msk-1/xx-split-trackball-keyboard/out/step/plate-left.step

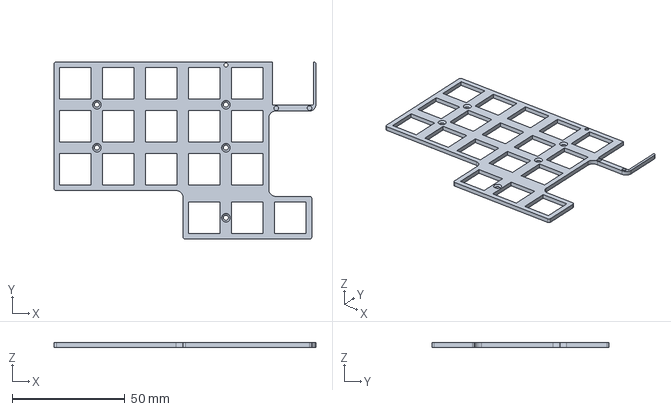
[picture p3: CAD file, 2026-11-07]
out/step/plate-left.step
116.1 x 78.6 x 2.00 mm
