msk-1/xx-split-trackball-keyboard/out/stl/asm/tag-left.stl

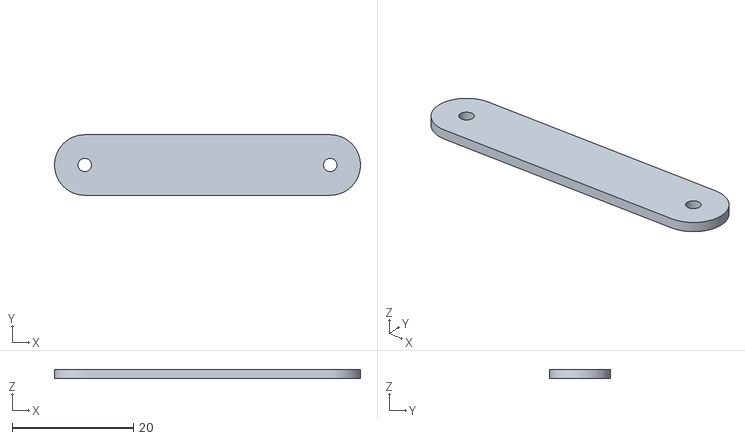
[picture p4: CAD file, 2026-11-07]
out/stl/asm/tag-left.stl
50.5 x 10.0 x 1.50
