msk-1/xx-split-trackball-keyboard/ref/BatteryHolder_Keystone_2460_1xAA.step

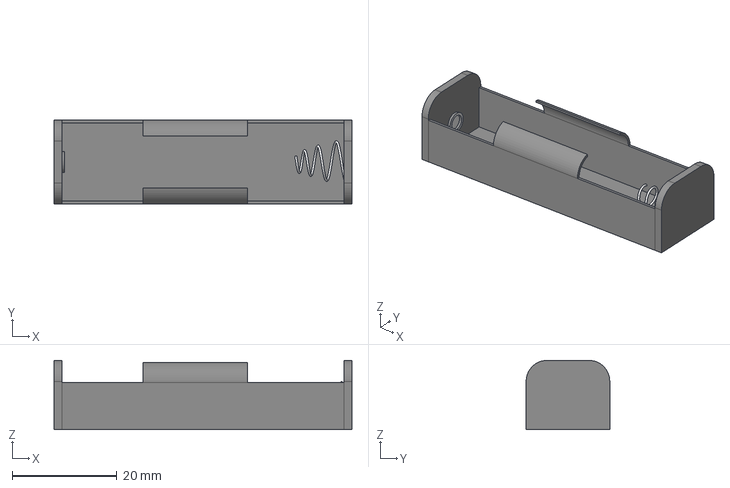
[picture p5: CAD file, 2026-11-07]
ref/BatteryHolder_Keystone_2460_1xAA.step
57.0 x 16.0 x 13.3 mm
