msk-1/xx-split-trackball-keyboard/out/step/battery-door-left.step

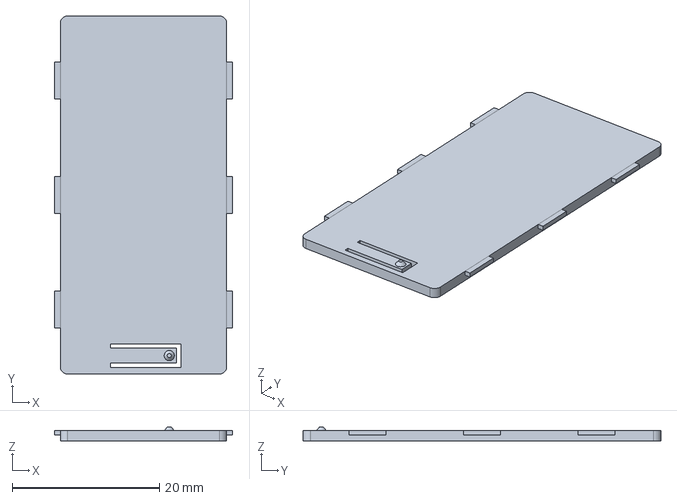
[picture p6: CAD file, 2026-11-07]
out/step/battery-door-left.step
24.2 x 48.6 x 1.89 mm
