msk-1/xx-split-trackball-keyboard/out/stl/asm/cover-right.stl

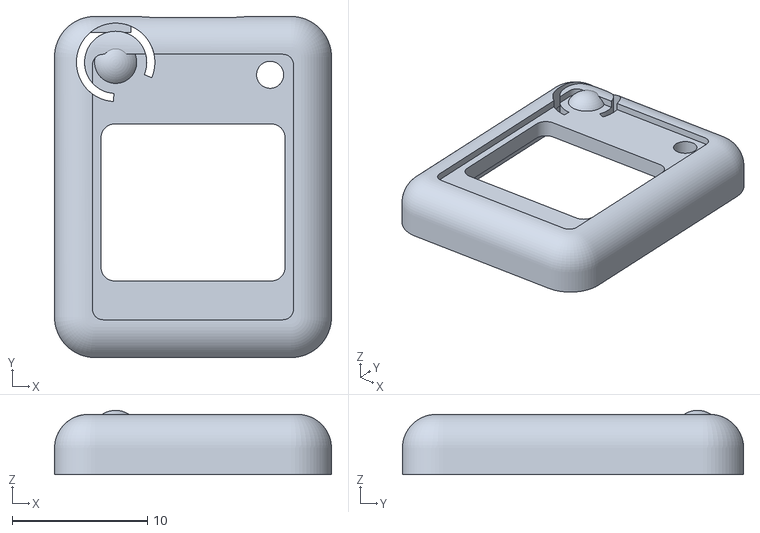
[picture p7: CAD file, 2026-11-07]
out/stl/asm/cover-right.stl
20.5 x 25.2 x 4.76
