msk-1/xx-split-trackball-keyboard/ref/choc-v2-red.step

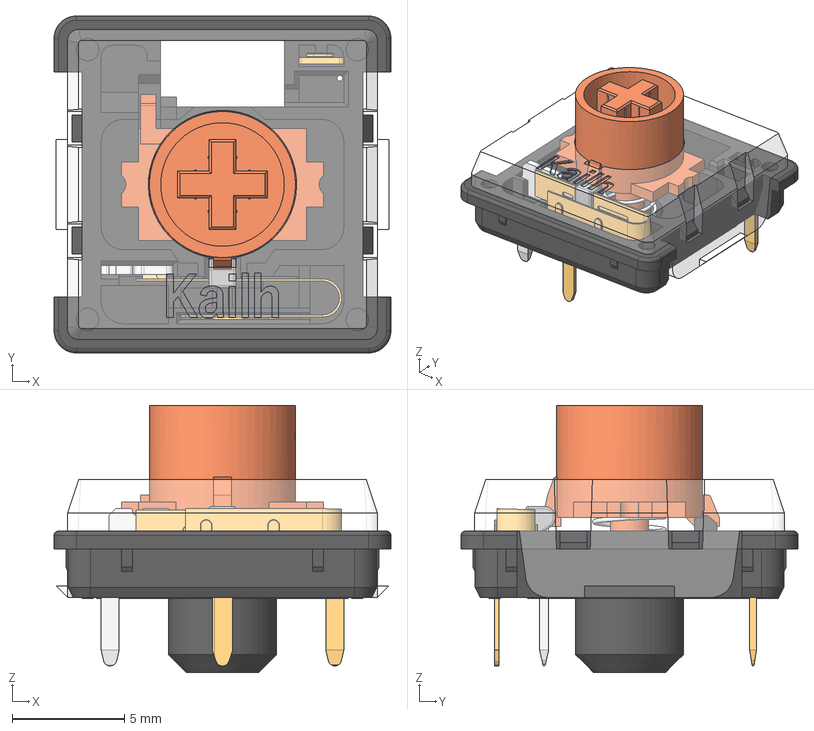
[picture p8: CAD file, 2026-11-07]
ref/choc-v2-red.step
15.0 x 15.0 x 11.9 mm
bottom
contact
pin1
stem
top
pin2
pin3
shrunken_spring
