msk-1/xx-split-trackball-keyboard/out/step/ball-base-right.step

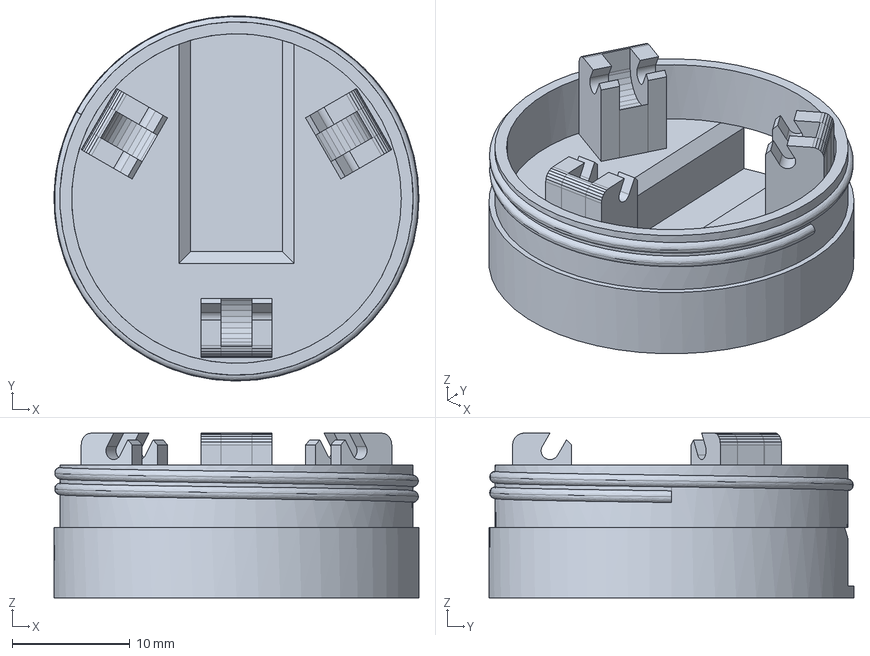
[picture p9: CAD file, 2026-11-07]
out/step/ball-base-right.step
31.0 x 31.0 x 14.0 mm
