msk-1/xx-split-trackball-keyboard/out/stl/asm/slider-right.stl

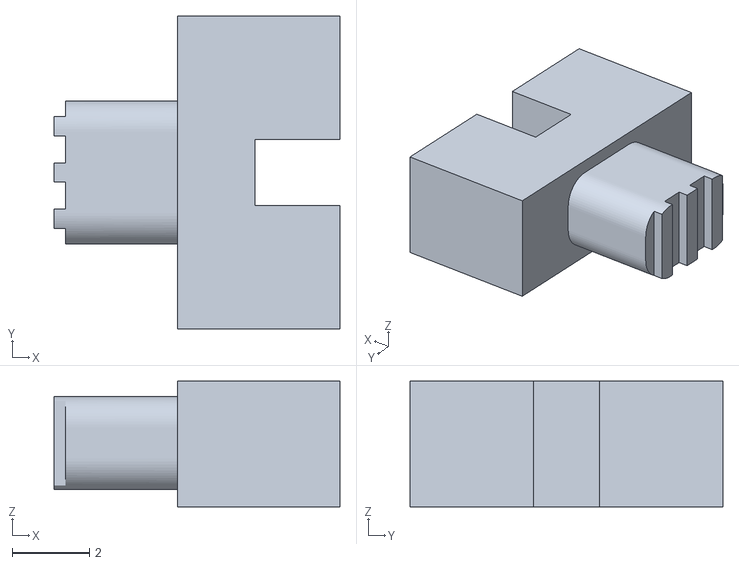
[picture p10: CAD file, 2026-11-07]
out/stl/asm/slider-right.stl
7.40 x 8.10 x 3.25
