msk-1/xx-split-trackball-keyboard/out/step/case-left.step

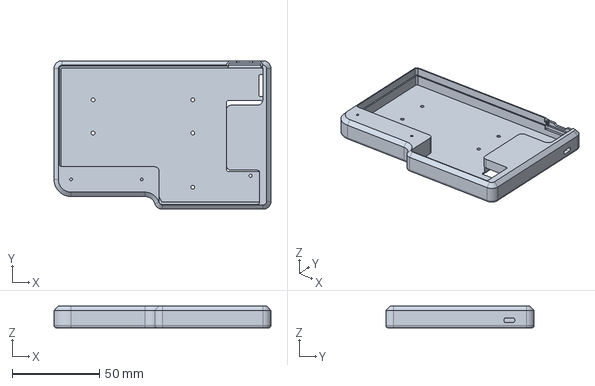
[picture p11: CAD file, 2026-11-07]
out/step/case-left.step
124.4 x 85.1 x 12.6 mm
