msk-1/xx-split-trackball-keyboard/out/stl/asm/keycaps-thumb-left.stl

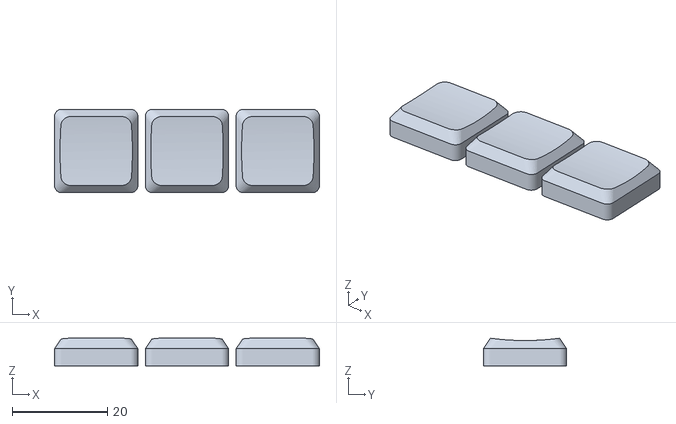
[picture p12: CAD file, 2026-11-07]
out/stl/asm/keycaps-thumb-left.stl
55.6 x 17.5 x 5.80
