msk-1/xx-split-trackball-keyboard/out/step/tag-right.step

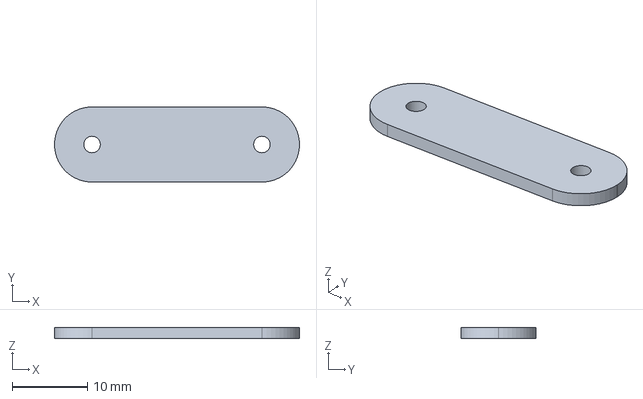
[picture p13: CAD file, 2026-11-07]
out/step/tag-right.step
32.6 x 10.0 x 1.50 mm
