msk-1/xx-split-trackball-keyboard/out/stl/asm/power-switch-left.stl

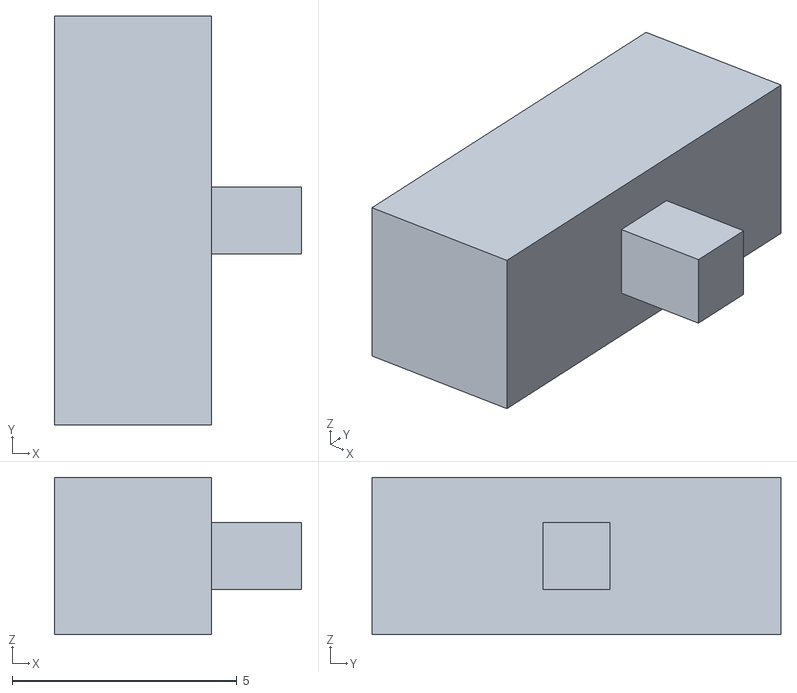
[picture p14: CAD file, 2026-11-07]
out/stl/asm/power-switch-left.stl
5.50 x 9.10 x 3.50
