msk-1/xx-split-trackball-keyboard/out/step/ball-ring.step

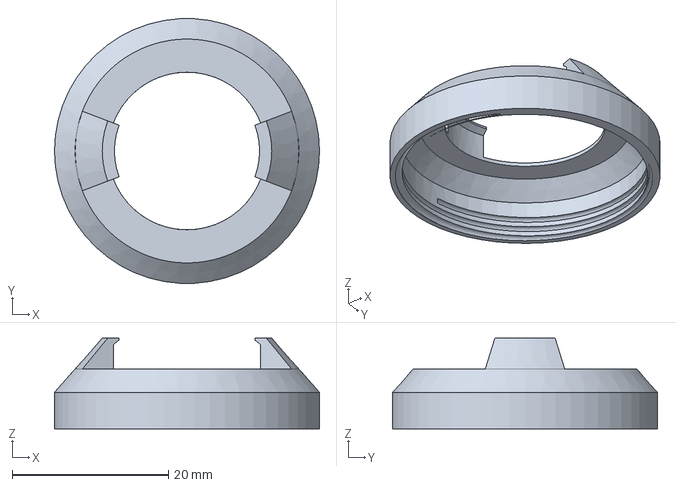
[picture p15: CAD file, 2026-11-07]
out/step/ball-ring.step
34.0 x 33.9 x 11.6 mm
