msk-1/xx-split-trackball-keyboard/out/stl/asm/sockets-right.stl

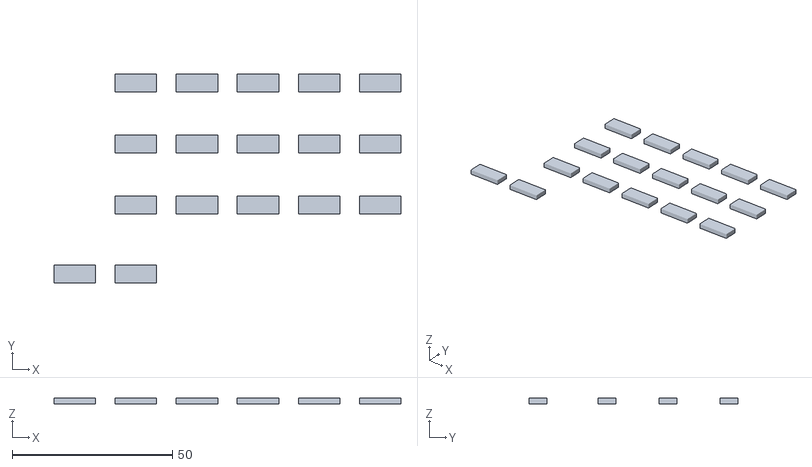
[picture p16: CAD file, 2026-11-07]
out/stl/asm/sockets-right.stl
108.2 x 65.2 x 1.85
