msk-1/xx-split-trackball-keyboard/out/step/slider-left.step

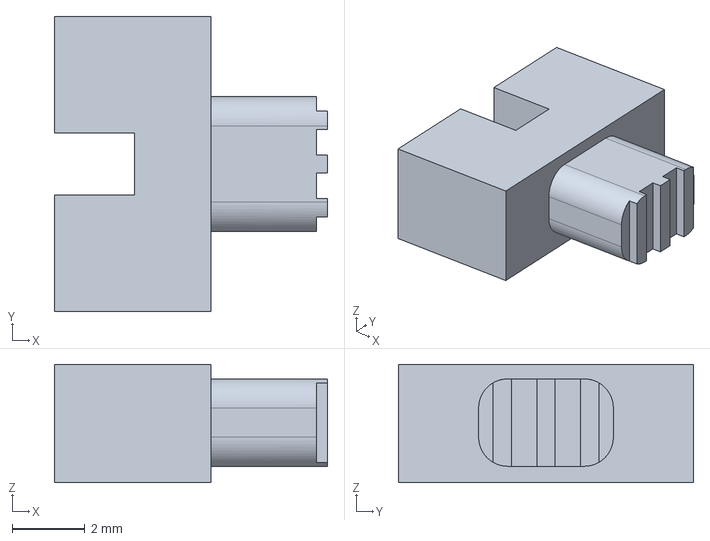
[picture p17: CAD file, 2026-11-07]
out/step/slider-left.step
7.50 x 8.10 x 3.25 mm
