msk-1/xx-split-trackball-keyboard/out/stl/asm/magnets-right.stl

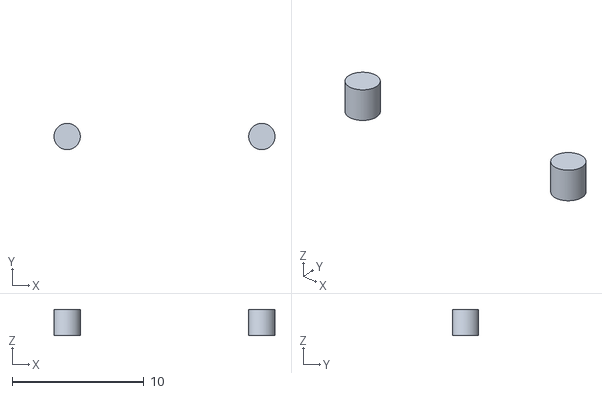
[picture p18: CAD file, 2026-11-07]
out/stl/asm/magnets-right.stl
16.8 x 2.00 x 2.00
