msk-1/xx-split-trackball-keyboard/out/stl/asm/usb-c-right.stl

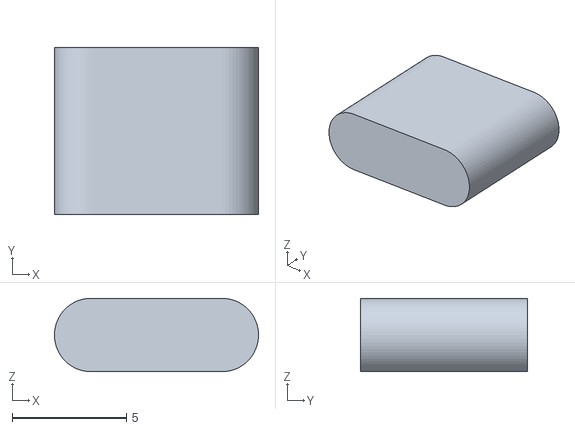
[picture p19: CAD file, 2026-11-07]
out/stl/asm/usb-c-right.stl
8.94 x 7.30 x 3.21
