msk-1/xx-split-trackball-keyboard/out/step/plate-right.step

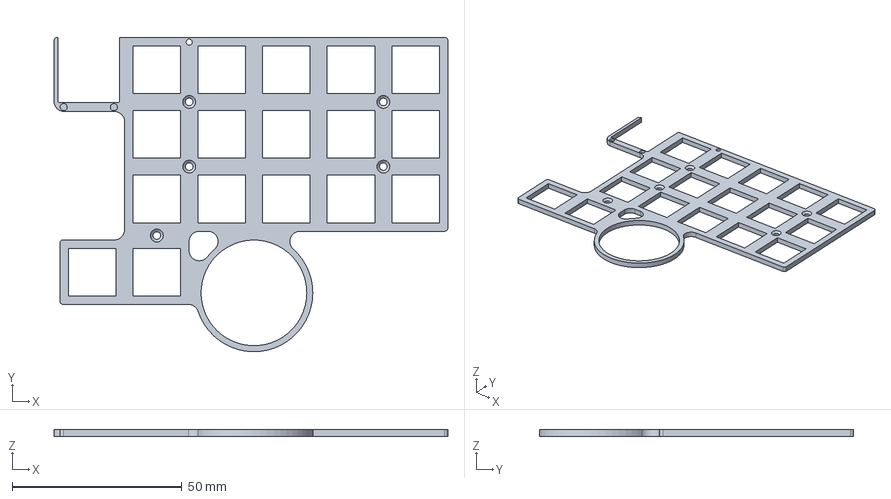
[picture p20: CAD file, 2026-11-07]
out/step/plate-right.step
116.0 x 92.6 x 2.00 mm
