msk-1/xx-split-trackball-keyboard/out/stl/asm/pcb-left.stl

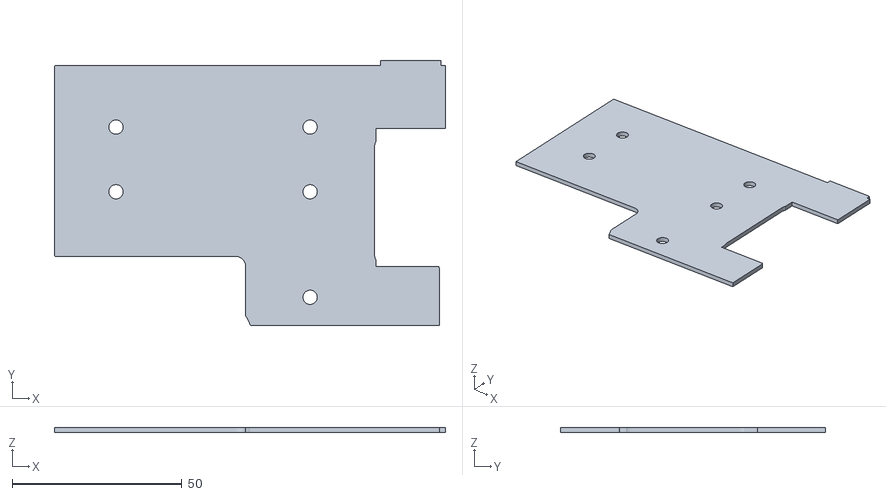
[picture p21: CAD file, 2026-11-07]
out/stl/asm/pcb-left.stl
115.1 x 78.0 x 1.60
