msk-1/xx-split-trackball-keyboard/out/step/case-right.step

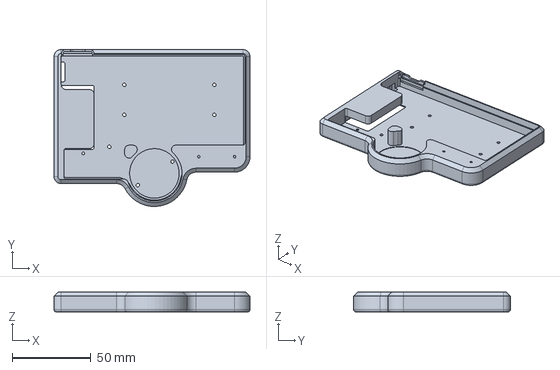
[picture p22: CAD file, 2026-11-07]
out/step/case-right.step
124.4 x 99.6 x 12.6 mm
