msk-1/xx-split-trackball-keyboard/out/stl/asm/sockets-left.stl

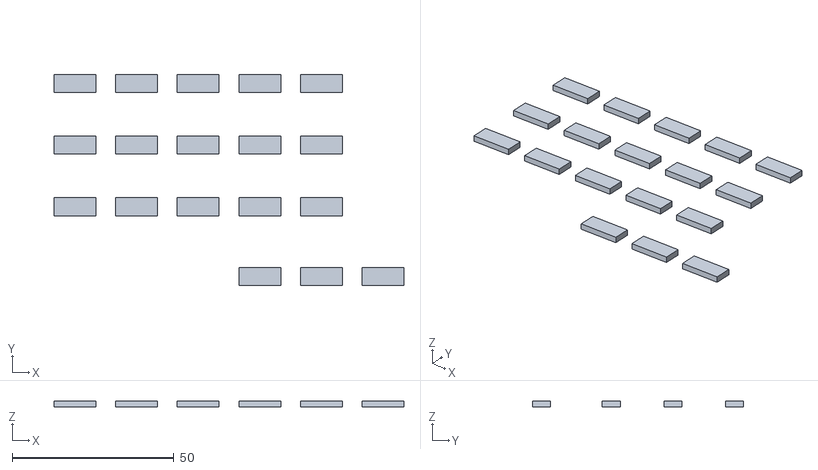
[picture p23: CAD file, 2026-11-07]
out/stl/asm/sockets-left.stl
108.2 x 65.2 x 1.85
