msk-1/xx-split-trackball-keyboard/out/step/slider-right.step

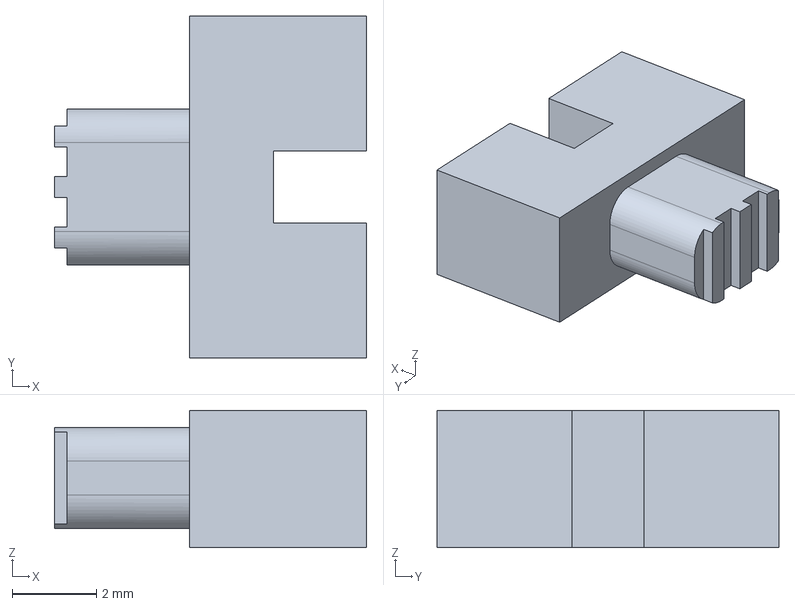
[picture p24: CAD file, 2026-11-07]
out/step/slider-right.step
7.40 x 8.10 x 3.25 mm
