msk-1/xx-split-trackball-keyboard/out/stl/asm/keycaps-right.stl

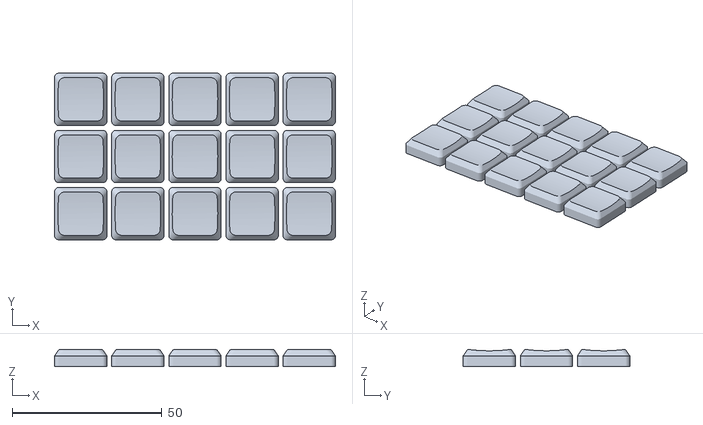
[picture p25: CAD file, 2026-11-07]
out/stl/asm/keycaps-right.stl
93.7 x 55.6 x 5.80
