msk-1/xx-split-trackball-keyboard/out/stl/asm/lipo-left.stl

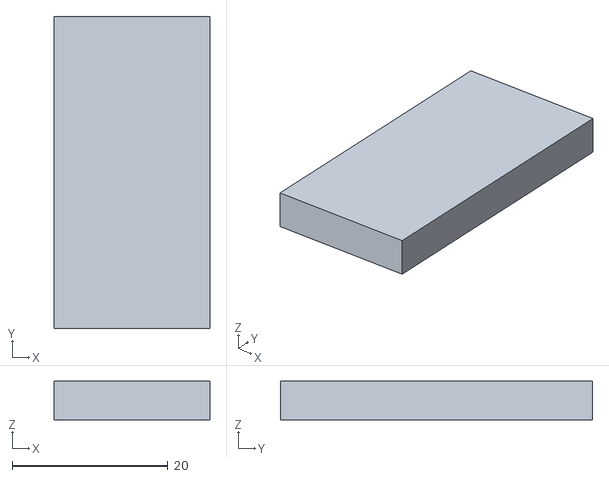
[picture p26: CAD file, 2026-11-07]
out/stl/asm/lipo-left.stl
20.0 x 40.0 x 5.00
