msk-1/xx-split-trackball-keyboard/out/stl/asm/keycaps-thumb-right.stl

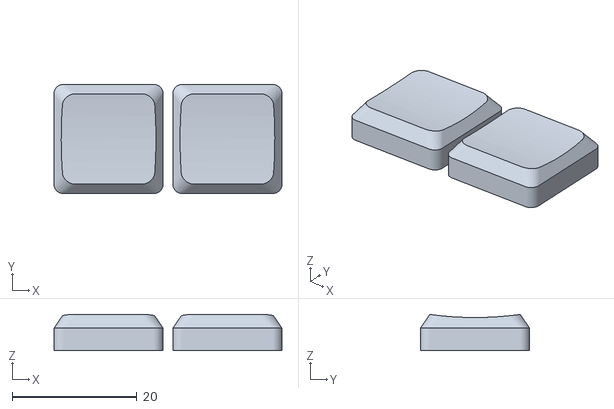
[picture p27: CAD file, 2026-11-07]
out/stl/asm/keycaps-thumb-right.stl
36.6 x 17.5 x 5.80
