msk-1/xx-split-trackball-keyboard/out/stl/asm/switches-right.stl

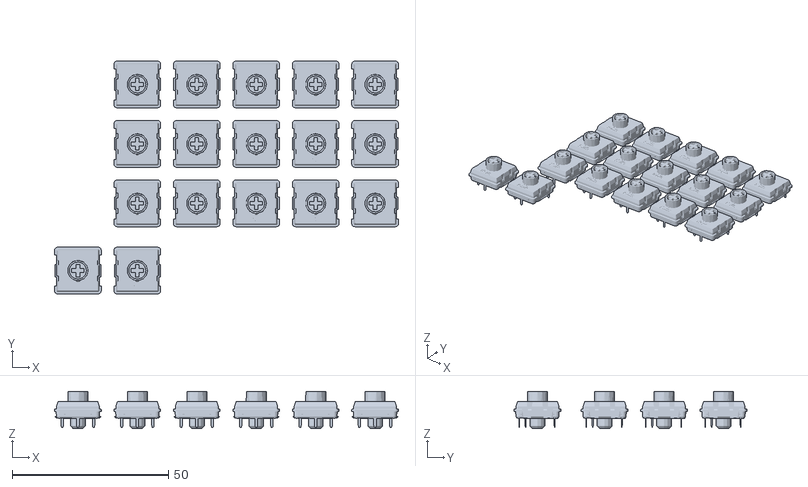
[picture p28: CAD file, 2026-11-07]
out/stl/asm/switches-right.stl
110.2 x 74.6 x 11.9
