msk-1/xx-split-trackball-keyboard/out/stl/asm/slider-left.stl

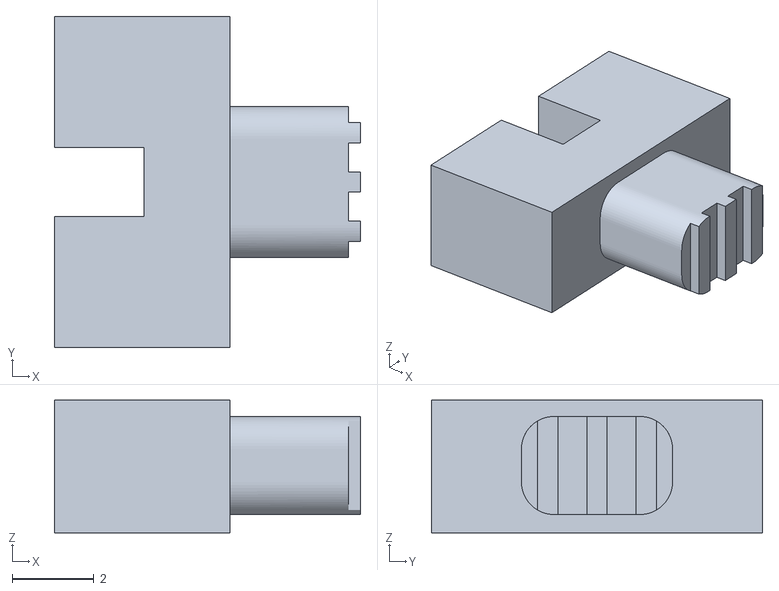
[picture p29: CAD file, 2026-11-07]
out/stl/asm/slider-left.stl
7.50 x 8.10 x 3.25
