msk-1/xx-split-trackball-keyboard/out/stl/asm/spacers-right.stl

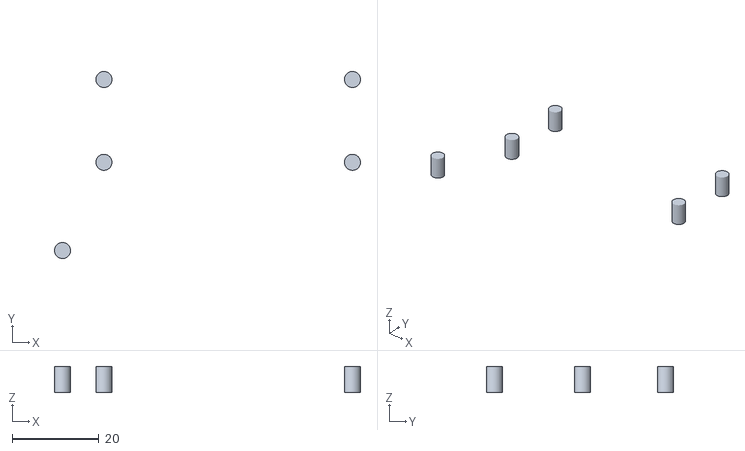
[picture p30: CAD file, 2026-11-07]
out/stl/asm/spacers-right.stl
70.4 x 43.0 x 6.00
