msk-1/xx-split-trackball-keyboard/out/stl/asm/bearings-right.stl

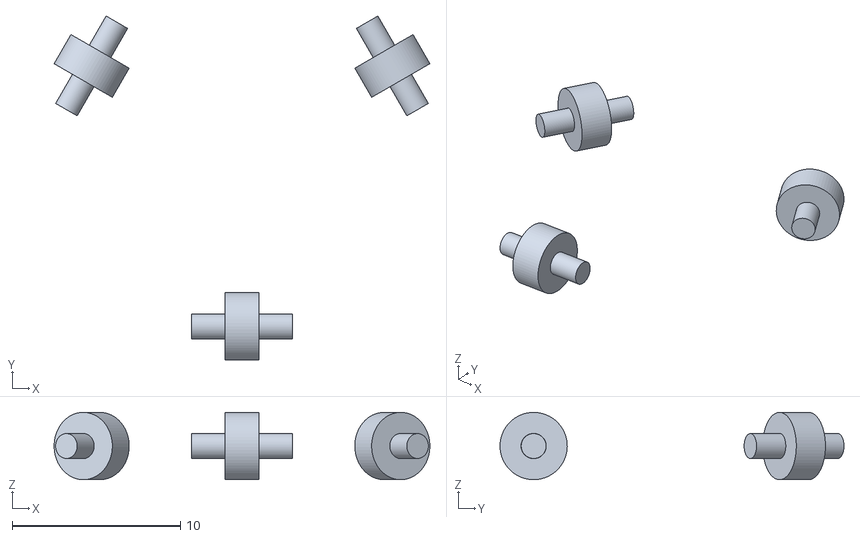
[picture p31: CAD file, 2026-11-07]
out/stl/asm/bearings-right.stl
22.3 x 20.4 x 4.00
