msk-1/xx-split-trackball-keyboard/out/stl/asm/pcb-right.stl

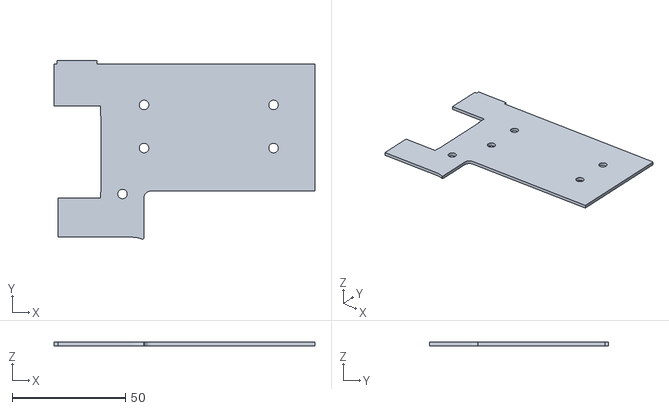
[picture p32: CAD file, 2026-11-07]
out/stl/asm/pcb-right.stl
115.2 x 79.0 x 1.60
