msk-1/xx-split-trackball-keyboard/out/stl/asm/switches-left.stl

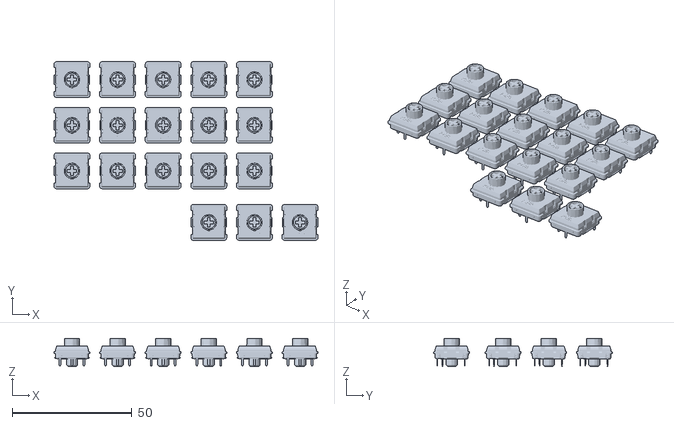
[picture p33: CAD file, 2026-11-07]
out/stl/asm/switches-left.stl
110.2 x 74.6 x 11.9
