msk-1/xx-split-trackball-keyboard/out/stl/asm/sensor-right.stl

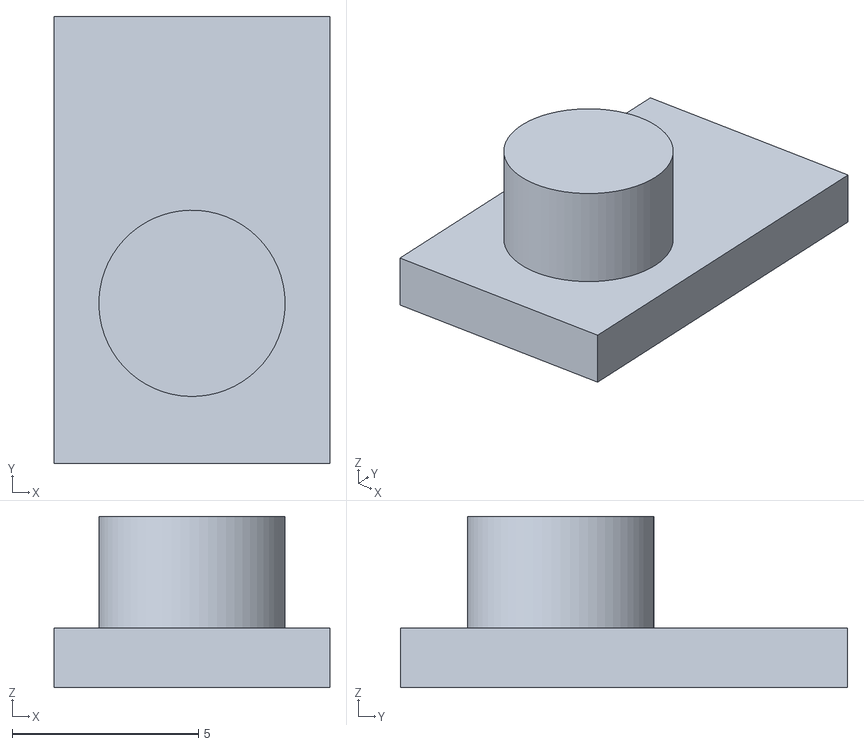
[picture p34: CAD file, 2026-11-07]
out/stl/asm/sensor-right.stl
7.40 x 12.0 x 4.60
