msk-1/xx-split-trackball-keyboard/out/stl/asm/ball-right.stl

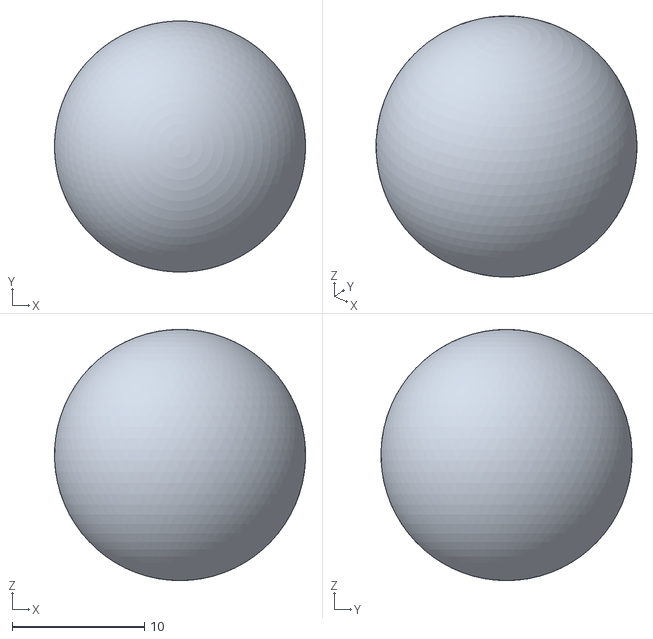
[picture p35: CAD file, 2026-11-07]
out/stl/asm/ball-right.stl
19.0 x 19.0 x 19.0
