msk-1/xx-split-trackball-keyboard/out/stl/asm/spacers-left.stl

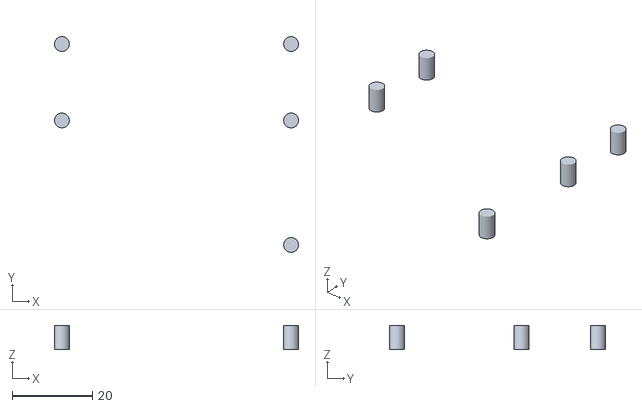
[picture p36: CAD file, 2026-11-07]
out/stl/asm/spacers-left.stl
60.8 x 53.8 x 6.00
