msk-1/xx-split-trackball-keyboard/(list of files, cad)

Other CAD files:
out/step/cover-left.step
out/stl/asm/ball-ring-right.stl
out/step/tag-left.step
out/step/cover-right.step
out/stl/asm/plate-right.stl
out/step/battery-door-right.step
out/stl/asm/battery-door-left.stl
out/stl/asm/power-switch-right.stl
out/stl/asm/tag-right.stl
out/stl/asm/magnets-left.stl
out/stl/asm/battery-door-right.stl
out/stl/asm/lipo-right.stl
out/stl/asm/case-left.stl
out/stl/asm/case-right.stl
out/stl/asm/cover-left.stl
out/stl/asm/plate-left.stl
out/stl/asm/keycaps-left.stl
out/stl/asm/ball-base-right.stl
out/stl/asm/usb-c-left.stl
out/stl/asm/screws-bottom-left.stl
out/stl/asm/screws-bottom-right.stl
out/stl/asm/screws-top-left.stl
out/stl/asm/screws-top-right.stl
out/stl/ball-base-right.stl
out/stl/ball-ring.stl
out/stl/battery-door-left.stl
out/stl/battery-door-right.stl
out/stl/case-left.stl
out/stl/case-right.stl
out/stl/cover-left.stl
out/stl/cover-right.stl
out/stl/plate-left.stl
out/stl/plate-right.stl
out/stl/slider-left.stl
out/stl/slider-right.stl
out/stl/tag-left.stl
out/stl/tag-right.stl
