msk-1/xx-split-trackball-keyboard/(commit log)

2026-11-07 単三電池の分割トラックボールキーボードのケースと 3D ビューアを置く
    XIAO nRF52840 の参考モデルと、それを含む出力は再配布の条件が不明なので入れない。
    web/ は GitHub Pages に置く（.github/workflows/pages.yml）。
    [BatteryHolder_Keystone_2460_1xAA.step, ball-base-right.step, ball-base-right.stl, ball-right.stl, ball-ring-right.stl, ball-ring.step, ball-ring.stl, battery-door-left.step]
2026-11-07 ビューア: 圧縮して送られた GLB を途中で捨てていたのを直す
    content-length を展開後のサイズとして配列を確保し、はみ出したところで読むのをやめていた。
    受け取った分をすべてつなぐようにする。
